CWQM/sensor-code/R4_Innovations_Open_Source_Sensor_Workshop_Data_Download_Visualization.pdf

# DATA DOWNLOAD

&

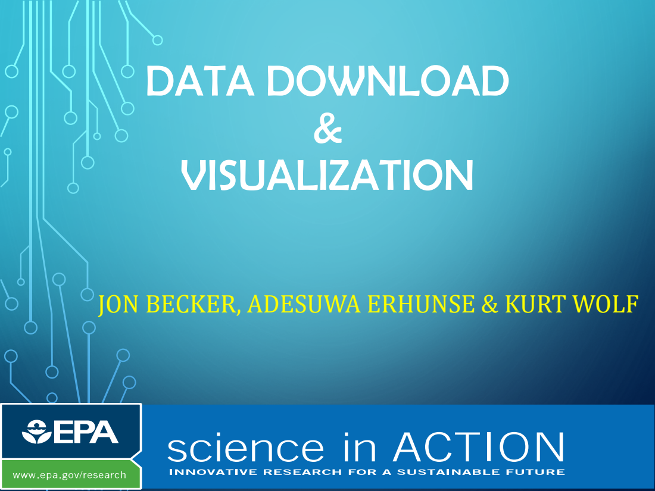
[picture p32: page 1]

VISUALIZATION
JON BECKER, ADESUWA ERHUNSE & KURT WOLF

# SET UP AN ACCOUNT

# - https://thingspeak.com

# - Internet of Things (IoT) cloud based analytics platform service

# - Capture, aggregate, visualize and serve live data streams

# - Getting Started:

# - Create an account – a free account is sufficient - Create a new channel – a channel corresponds to a deployed sensor package - Setup your channel – add your variables and metadata - Record your Channel ID, Read API Key, Write API Key and User API Key

# SET UP A CHANNEL

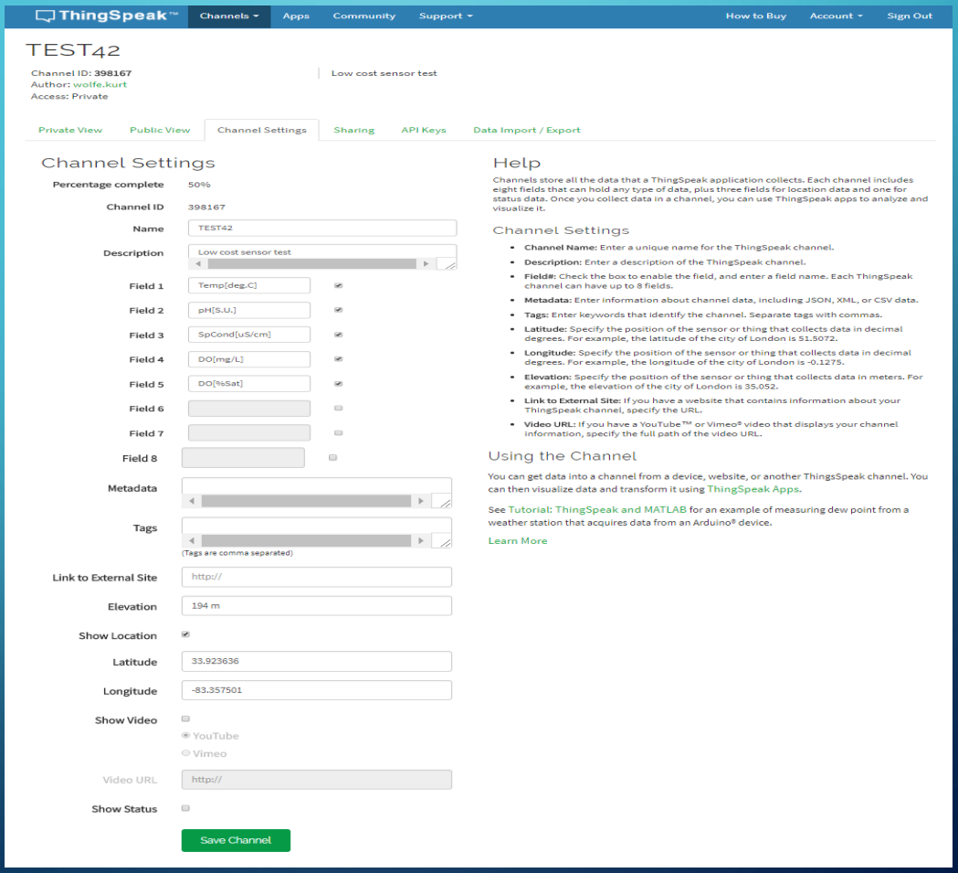
[picture p33: figure]

# - Option One

# - Export data from SD card and import to Excel

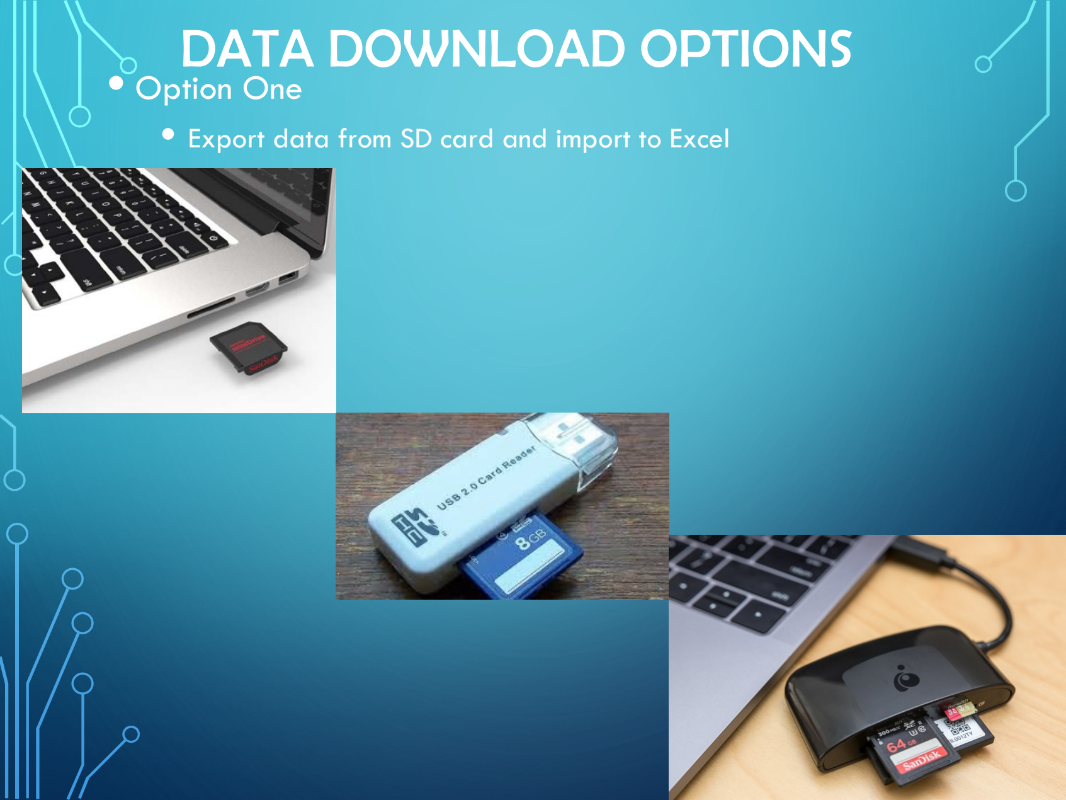
[picture p34: page 4]

# DATA DOWNLOAD OPTIONS

# - Option Two

# - Export data from ThingSpeak and import to Excel

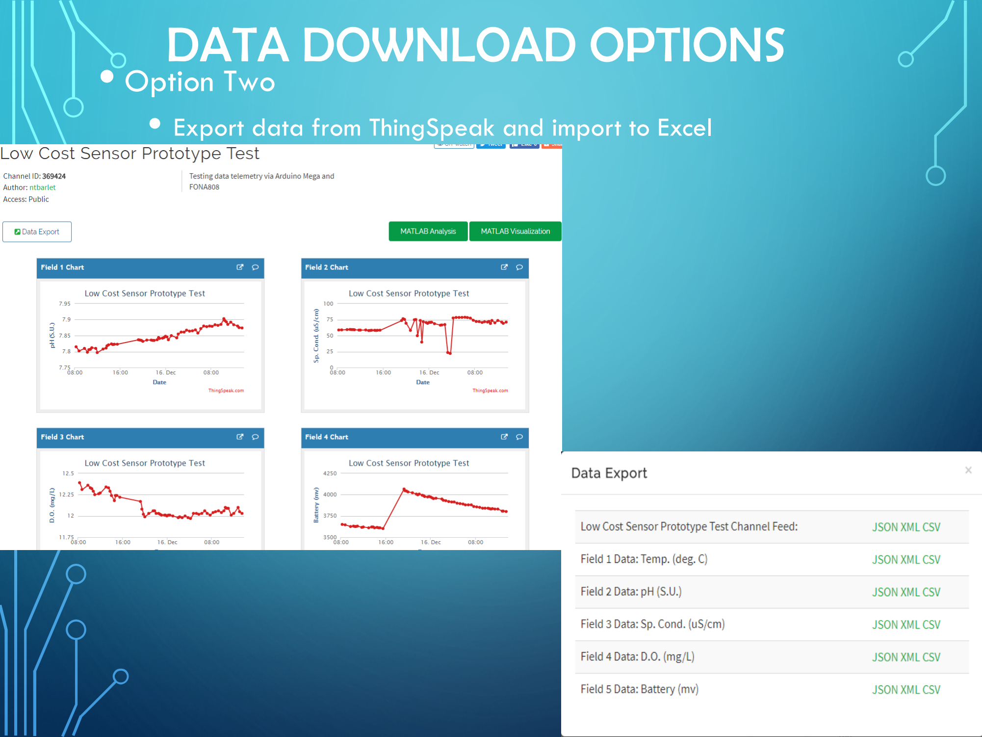
[picture p35: page 5]

# DATA DOWNLOAD OPTIONS

# - Option Two

# - Export data from ThingSpeak and import to Excel

# DATA DOWNLOAD OPTIONS

# - Make sure your CSV file is properly formatted with all the relevant field headers defined as:

datetime, field1, field2, field3, field4, field5, field6, field7,

# field8, altitude, longitude, elevation, status

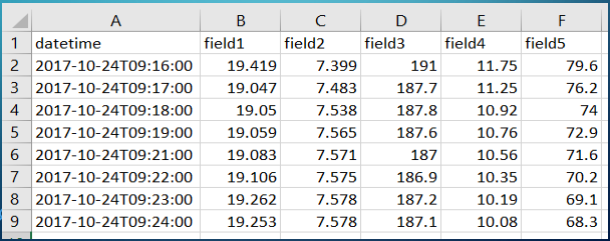
[picture p36: figure]

# - Retrieving Data

# DATA DOWNLOAD OPTIONS

# https://api.thingspeak.com/channels/398167/feeds.json?api_key=Q3SAZ0MGWY86TH64&results=2

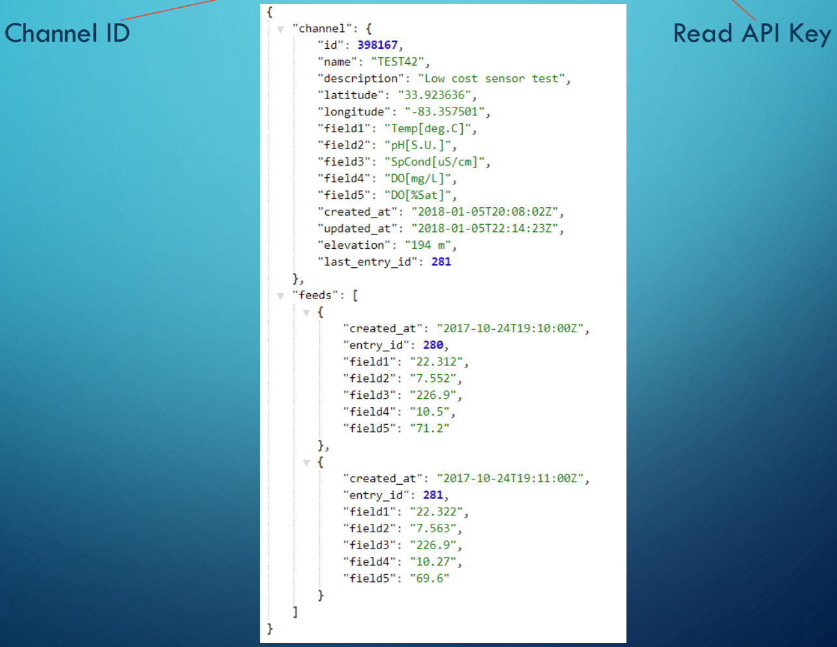
[picture p37: figure]
Channel ID; Read API Key

# DATA VISUALIZATION

## LCS Test October 24, 2017

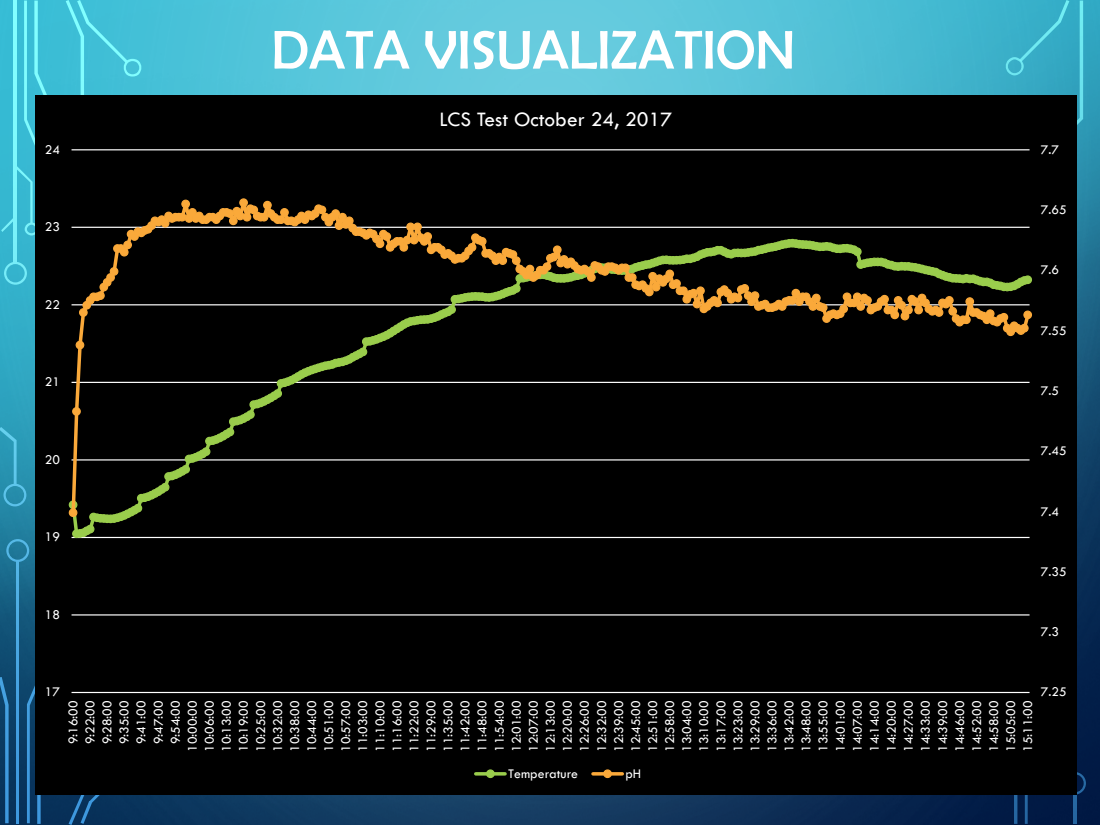
[picture p38: page 8]
Temperature

# DATA VISUALIZATION

## LCS Test October 24, 2017

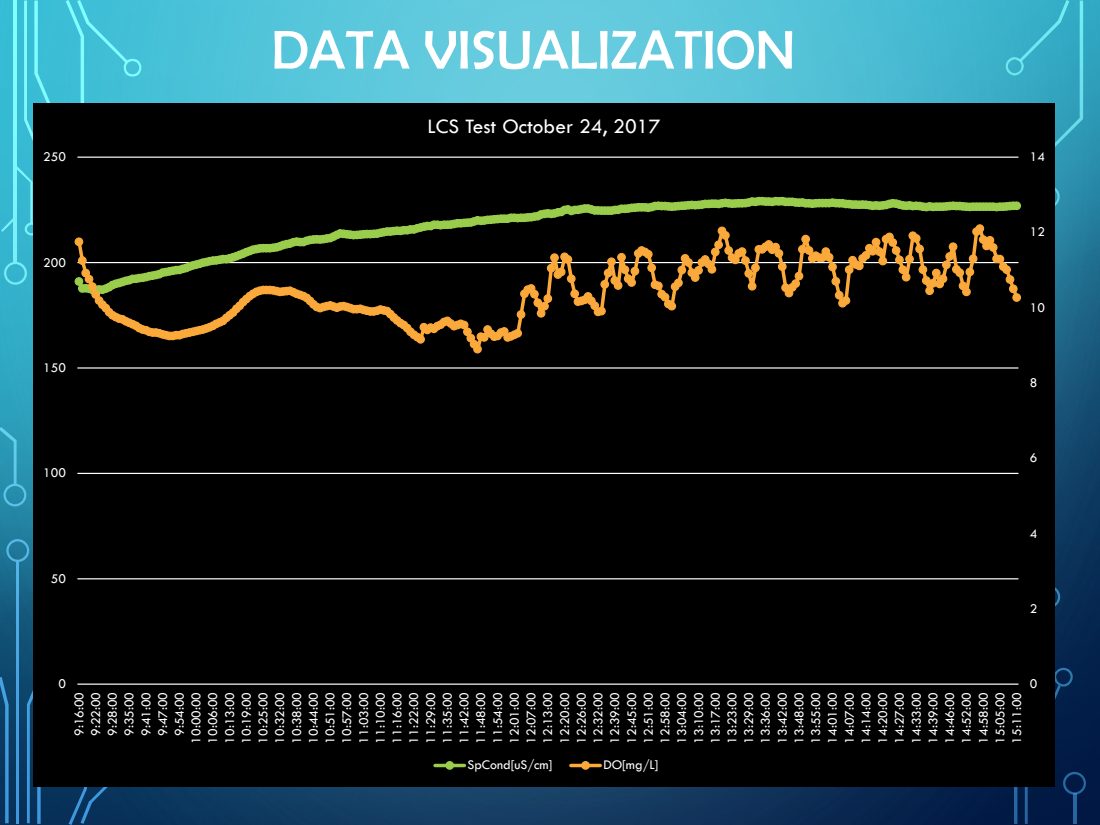
[picture p39: page 9]
SpCond[uS/cm]

# LOOKING TOWARDS THE FUTURE

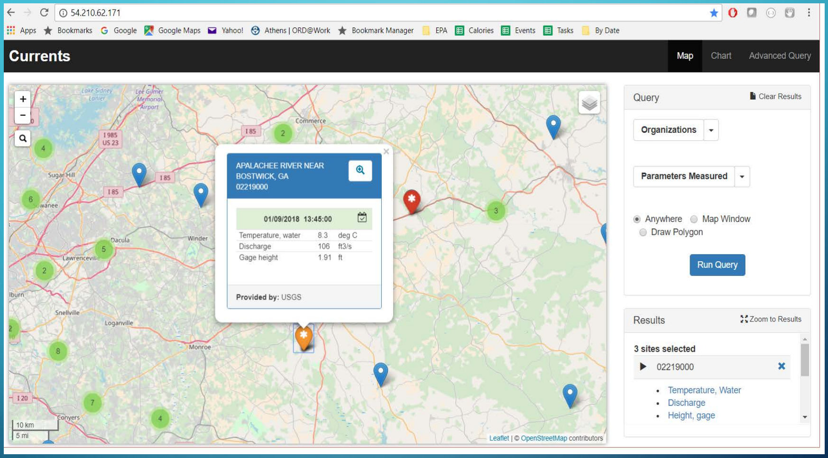
[picture p40: figure]

# DATA DOWNLOAD

&

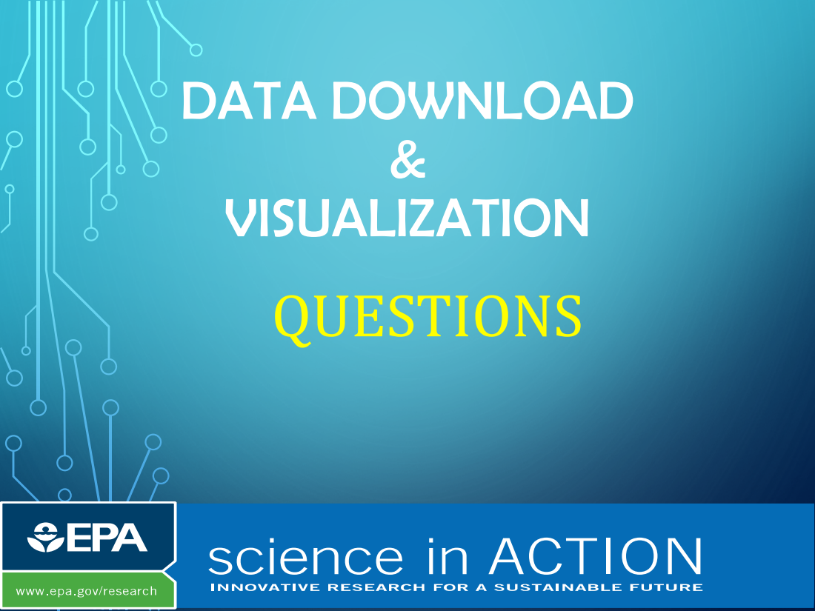
[picture p41: page 11]
VISUALIZATION; QUESTIONS
