CWQM/sensor-code/EPA_R4_Innovations_Low_Cost_WQ_Sensor_Wiring_Diagram.pdf

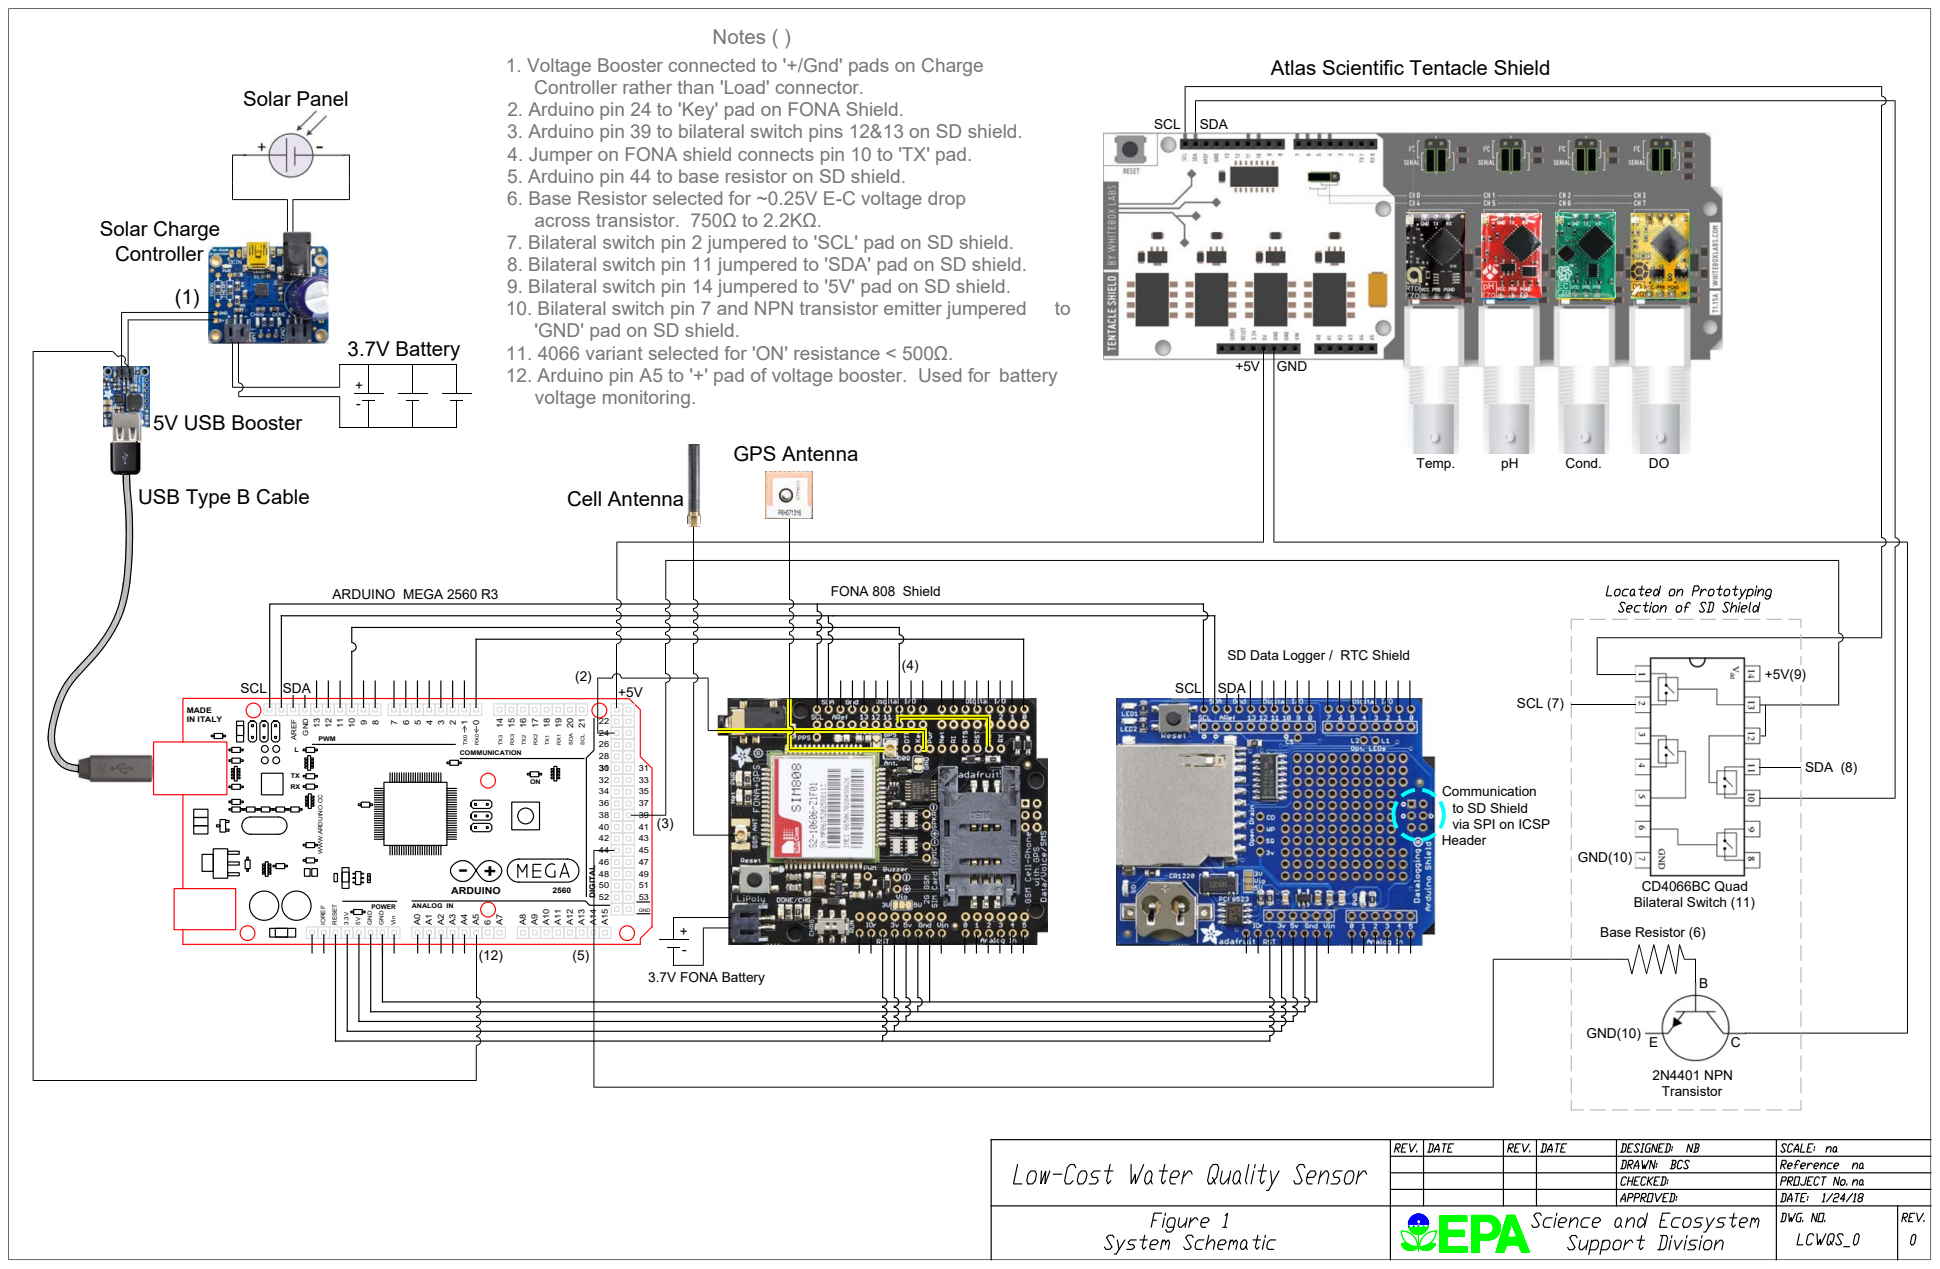
[picture p88: page 1]
POWER; ANALOG IN; COMMUNICATION; ARDUINO; DIGITAL; GND; SDA; SCL; GND AREF PWM; MADE IN ITALY; IOREF; RESET; Vin; Solar Charge Controller; Solar Panel; 5V USB Booster; 3.7V Battery; 10. Bilateral switch pin 7 and NPN transistor emitter jumpered; GND(10); Base Resistor (6); 2N4401 NPN Transistor; SCL (7); SDA (8); FONA 808 Shield; Cell Antenna; CD4066BC Quad Bilateral Switch (11); ARDUINO MEGA 2560 R3; +5V GND; GPS Antenna; 3.7V FONA Battery; Temp.; Cond.; SDA (2); Notes ( )

1. Voltage Booster connected to '+/Gnd' pads on Charge
Controller rather than 'Load' connector.
2. Arduino pin 24 to 'Key' pad on FONA Shield.
3. Arduino pin 39 to bilateral switch pins 12&13 on SD shield.
4. Jumper on FONA shield connects pin 10 to 'TX' pad.
5. Arduino pin 44 to base resistor on SD shield.
6. Base Resistor selected for ~0.25V E-C voltage drop
across transistor. 750Ω to 2.2KΩ.
7. Bilateral switch pin 2 jumpered to 'SCL' pad on SD shield.
8. Bilateral switch pin 11 jumpered to 'SDA' pad on SD shield.
9. Bilateral switch pin 14 jumpered to '5V' pad on SD shield.
'GND' pad on SD shield.
11. 4066 variant selected for 'ON' resistance < 500Ω.
12. Arduino pin A5 to '+' pad of voltage booster. Used for battery
voltage monitoring.

Atlas Scientific Tentacle Shield

USB Type B Cable

SD Data Logger / RTC Shield

Communication
to SD Shield
via SPI on ICSP
Header

WWW.ARDUINO.CC
