CWQM/sensor-code/(commit log)

2018-01-29 Sensor Design Workshop Presentations
    Presentations from the USEPA Open Source Water Quality Sensor Design Workshop held at the Region 4 Science & Ecosystem Support Division in Athens, GA on January 23rd and 24th, 2018.
2018-01-30 Added updated file without version in filename so git can track
2018-08-01 Wiring Schematic
    Wiring Schematic
