CWQM/sensor-code/(notices)

Notices in the files:
tentacle_setup_and_Calibration/tentacle_setup_and_Calibration.ino:
This program is free software: you can redistribute it and/or modify
it under the terms of the GNU General Public License as published by
the Free Software Foundation, either version 3 of the License, or
at your option) any later version.
